AlexGyver/GyverRGB/gerber/dip.jpg

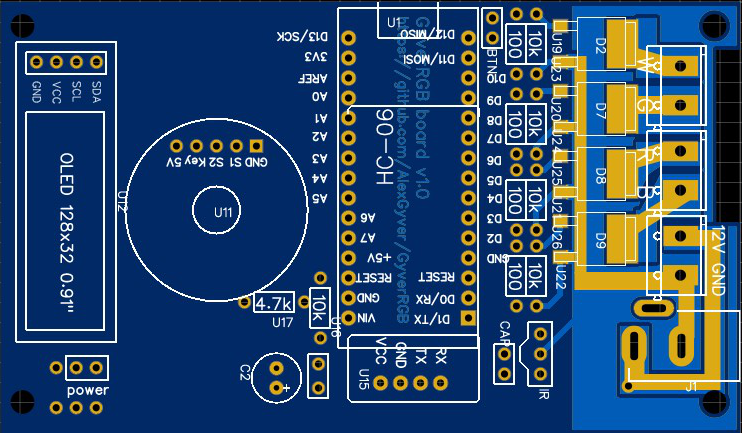
gerber/dip.jpg
