AlexGyver/GyverRGB/gerber/drv.jpg

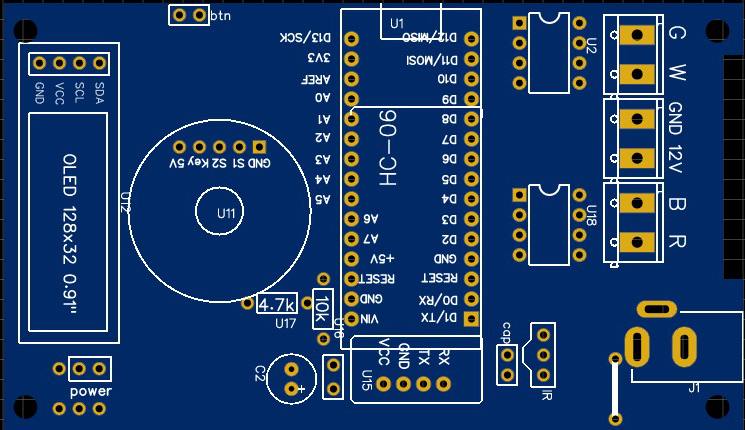
gerber/drv.jpg
