AlexGyver/GyverRGB/gerber/smd.jpg

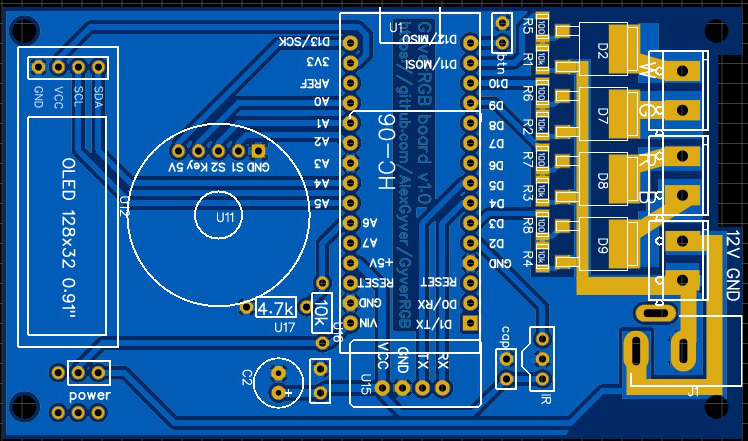
gerber/smd.jpg
