AlexGyver/GyverRGB/schemes/scheme3.jpg

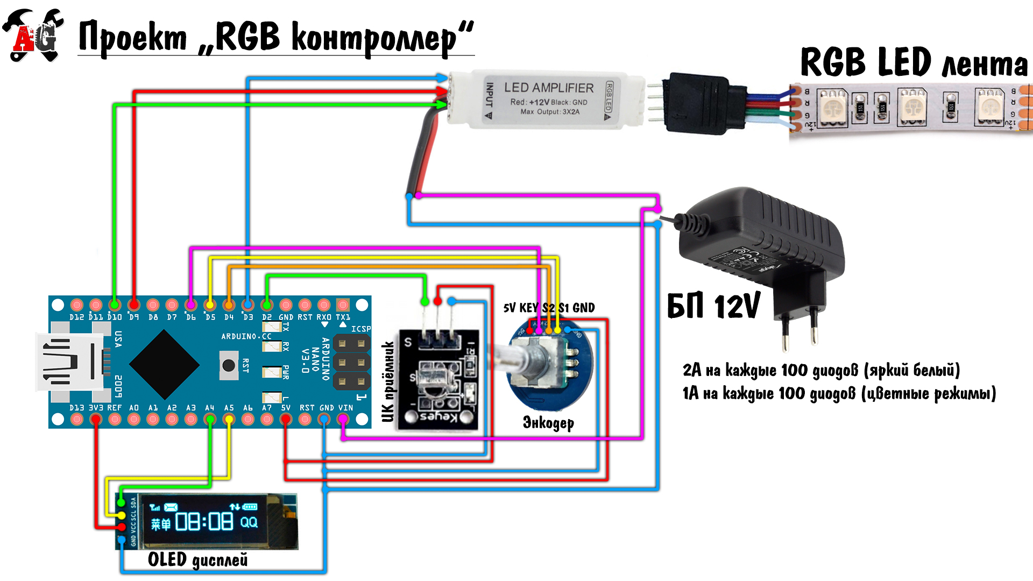
schemes/scheme3.jpg
