AlexGyver/GyverRGB/schemes/scheme4.jpg

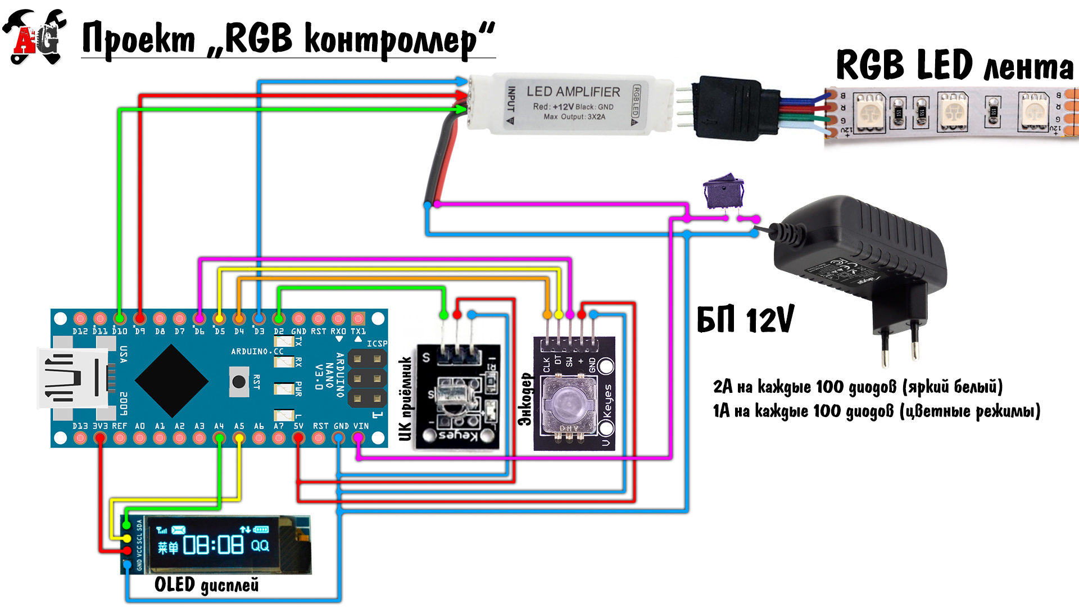
schemes/scheme4.jpg
